RaymondTirta/SmartQuarium/backend/README.md

node server.js
or
nodemon server.js
library used:
- express
- axios
- mqtt.js
- mongodb driver
